FVSproject/neuroguard/Files/components.jpeg

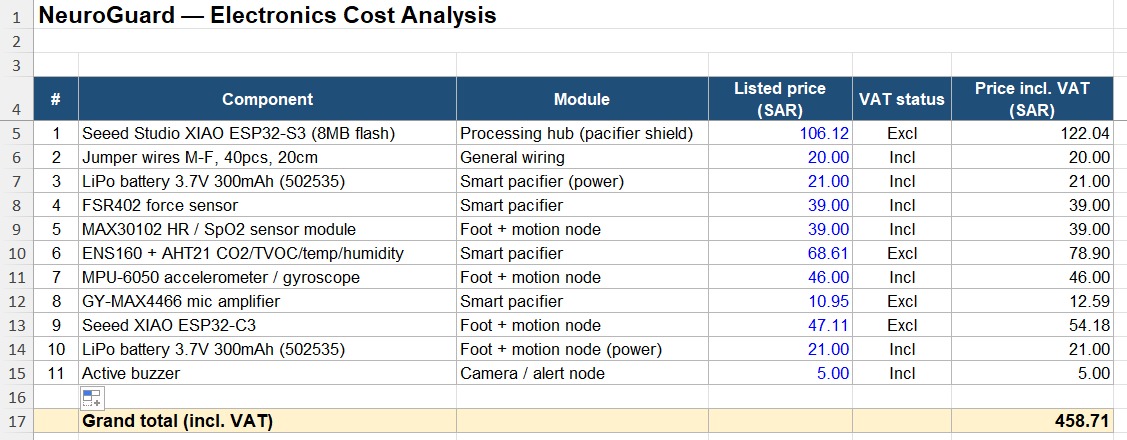
Files/components.jpeg
