FVSproject/neuroguard/Circuit/blueprint hub.png

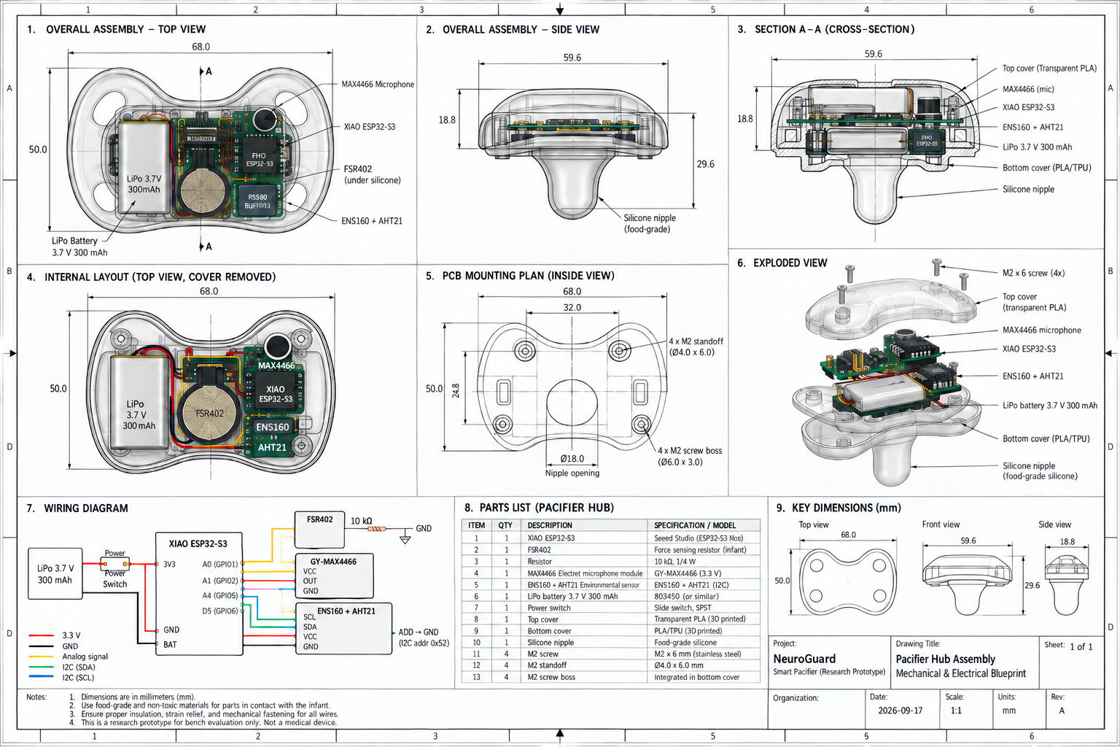
Circuit/blueprint hub.png
