FVSproject/neuroguard/Files/متلازمه_موت_الطفل_المفاجئ_Sudden_Infant_Death_Syndrome.pdf

### ما الذي يحدث فعليًا في متالزمه موت الطفل المفاجئ (SIDS (Syndrome Death Infant Sudden؟

### Brainstem Dysfunction Hypothesis

أي أن المشكلة األساسية ليست في الرئة أو القلب وحدهما، بل في جذع الدماغ.(Brainstem(

جذع الدماغ مسؤول عن:

- التنفس
- االستيقاظ من النوم
- تنظيم نبض القلب
- االستجابة لنقص األكسجين
- االستجابة الرتفاع ₂CO

وقد وجدت دراسات تشريحية متكررة وجود اضطرابات في نظام السيروتونين (System Serotonin (داخل جذع الدماغ لدى عدد كبير من أطفال SIDS.

### The Brainstem and Serotonin in the Sudden Infant Death Syndrome | Annual

Reviews (https://www.annualreviews.org/content/journals/10.1146/annurev.pathol.4.110807.092322)

ما معنى فشل االستيقاظ؟

عندما يرتفع ₂CO أثناء النوم يحدث تسلسل طبيعي:

.1 زيادة ₂CO

.2 تنشيط مستقبالت كيميائية في الدماغ .

.3 زيادة التنفس .

.4 زيادة نبض القلب .

.5 االستيقاظ .

.6 تغيير وضعية الرأس .

هذا يسمى:

### Protective Arousal Response

وقد أظهرت الدراسات أن هذه االستجابة تعتمد بشكل أساسي على دوائر عصبية داخل جذع الدماغ .

### Sudden Infant Death Syndrome, Sleep, and the Physiology and Pathophysiology of the Respiratory Network - SIDS Sudden Infant and Early Childhood Death -NCBI Bookshelf (https://www.ncbi.nlm.nih.gov/books/NBK513387/)

وجد الباحثون أن األطفال الذين توفوا الحقً SIDS أظهروا قبل الوفاة مؤشرات مثل: | ا بـ
- اضطرابات بالتنفس .

- تغيرات في HRV .
- نقص االستيقاظ .
- خلل باالستجابات الذاتية .

وكلها تشير إلى خلل في الجهاز العصبي الذاتي .

)نستنتج أن مجموعة فرعية مهمة من الرضع الذين يتوفون فجأة يعانون من اضطرابات في السيروتونين ناتجة عن "آفة مركزية" في التكوين الشبكي للنخاع المستطيل، والذي يتألف من نوى تحتوي على خاليا عصبية سيروتونينية. قد تؤدي هذه اآلفة إلى فشل استجابات جذع الدماغ الوقائية للتحديات التي تواجه التوازن الداخلي أثناء النوم في فترة نمو حرجة، مما يسبب الموت المفاجئ المرتبط بالنوم.(

### The Serotonin Brainstem Hypothesis for the Sudden Infant Death Syndrome -PMC (https://pmc.ncbi.nlm.nih.gov/articles/PMC6934437/)

المشروع:

### NeuroGuard

"تطوير نظام لهاية ذكية متعددة الحساسات لمراقبة ديناميكيات المص غير المغذي، وتقلب معدل ضربات القلب، والمؤشرات الحيوية التنفسية المرتبطة بخلل اليقظة عند الرضع"

### "Development of a Multi-Sensor Smart Pacifier System for Monitoring Non-Nutritive Sucking Dynamics, Heart Rate Variability, and Respiratory Biomarkers Associated with Arousal Dysfunction in Infants"

### الملخص(Abstract(

تُعد متالزمة موت الرضع المفاجئ (SIDS ,Syndrome Death Infant Sudden (من أهم أسباب الوفاة غير المفسرة خالل السنة األولى من العمر. وعلى الرغم من عقود من البحث العلمي، ال تزال اآلليات الفيزيولوجية الدقيقة المسؤولة عن حدوثها غير مفهومة بالكامل. تشير األدلة الحديثة إلى أن الخلل في جذع الدماغ واضطراب التنظيم العصبي الذاتي وفشل آليات االستيقاظ الوقائية (Failure Arousal (تمثل عوامل رئيسية في تطور المتالزمة. يهدف هذا المشروع إلى تطوير نظام ذكي متعدد المستشعرات يعتمد على مصاصة ذكية وحساسات فسيولوجية قابلة لالرتداء وخوارزميات ذكاء اصطناعي لتحليل المؤشرات العصبية والتنفسية بصورة متزامنة. يعتمد النظام على قياس معدل التنفس، وثاني أكسيد الكربون في الزفير، ومعدل ضربات القلب، وتباين ضربات القلب(HRV (، وتشبع األكسجين، باإلضافة إلى خصائص المص غير الغذائي (NNS ,Sucking Nutritive-Non (وتفترض الدراسة أن دمج هذه المؤشرات قد يتيح اكتشاف عالمات مبكرة على اضطراب التنظيم العصبي الذاتي المرتبط بفشل االستيقاظ قبل ظهور األحداث السريرية الخطرة .

المقدمة

تمثل متالزمة موت الرضع المفاجئ حالة وفاة مفاجئة وغير متوقعة لطفل أقل من سنة واحدة تبقى غير مفسرة حتى بعد التشريح الكامل وتحليل ظروف الوفاة والتاريخ الطبي. وتشير النماذج الحديثة إلى أن SIDS تنشأ نتيجة تفاعل بين قابلية بيولوجية كامنة، ومرحلة حرجة من تطور الجهاز العصبي، وعامل بيئي ضاغط أثناء النوم، فيما يعرف بـ .Model Risk Triple وقد أدت هذه الفرضية إلى توجيه االهتمام نحو دراسة الجهاز العصبي الذاتي ووظائف جذع الدماغ باعتبارهما مركزين رئيسيين لتنظيم التنفس واالستيقاظ .

الخلفية العلمية

- اضطرابات جذع الدماغ في SIDS

أظهرت الدراسات العصبية أن العديد من ضحايا SIDS يمتلكون اضطرابات في مناطق من جذع الدماغ مسؤولة عن التحكم بالتنفس، واالستجابة لنقص األكسجين، وتنظيم نبض القلب، واالستيقاظ من النوم. كما أشارت األبحاث إلى وجود خلل في أنظمة السيروتونين ضمن النخاع المستطيل، وهي مناطق تشارك في التحكم القلبي التنفسي واالستجابات الوقائية أثناء النوم. ويُعتقد أن هذا الخلل قد يضعف قدرة الرضيع على اكتشاف االختناق أو فرط ثاني أكسيد الكربون واالستجابة لهما بصورة مناسبة .

### Autonomic Cardiorespiratory Physiology and Arousal of the Fetus and Infant -

SIDS Sudden Infant and Early Childhood Death - NCBI Bookshelf (https://www.ncbi.nlm.nih.gov/books/NBK513398/)

### - فرضية فشل االستيقاظ (Failure Arousal(

تشير الدراسات إلى أن ارتفاع تركيز ثاني أكسيد الكربون أو انخفاض األكسجين يؤدي في الحالة الطبيعية إلى سلسلة استجابات تبدأ بزيادة الجهد التنفسي ثم تغيرات في معدل القلب والحركة واالستيقاظ من النوم وإعادة تموضع الرأس. وقد أظهرت أبحاث النوم أن هذه االستجابات تنط لق أسا ًسا من دوائر موجودة في جذع الدماغ. وتفترض فرضية فشل االستيقاظ أن بعض الرضع المعرضين لـ SIDS ال ينجحون في تفعيل هذه اآلليات الدفاعية، مما يؤدي إلى استمرار نقص األكسجين حتى الوصول إلى مرحلة حرجة .

### Sudden Infant Death Syndrome, Sleep, and the Physiology and Pathophysiology of the Respiratory Network - SIDS Sudden Infant and Early Childhood Death -NCBI Bookshelf (https://www.ncbi.nlm.nih.gov/books/NBK513387/)

### Animal Models: Illuminating the Pathogenesis of Sudden Infant Death Syndrome

- SIDS Sudden Infant and Early Childhood Death - NCBI Bookshelf (https://www.ncbi.nlm.nih.gov/books/NBK513377/)
- تباين ضربات القلب(HRV(

يعد HRV أحد أكثر المؤشرات استخدا ًما لتقييم نشاط الجهاز العصبي الذاتي. فهو يعكس التوازن بين الجهاز العصبي الودي والجهاز العصبي نظير الودي ويُستخدم لتقييم نضج التنظيم القلبي التنفسي لدى الرضع. أظهرت
دراسات على أطفال تعرضوا الحقً SIDS أو ألحداث تهدد الحياة وجود اختالفات في بعض مؤشرات HRV | ا لـ
مقارنة باألطفال الطبيعيين، مما يشير إلى أن HRV قد يمثل مؤش ًرا غير مباشر على سالمة التنظيم العصبي الذاتي .
Heart rate variability in infants with apparent life-threatening events - PubMed (https://pubmed.ncbi.nlm.nih.gov/11106044/)

### Heart rate variability in infants subsequently suffering sudden infant death

syndrome (SIDS) - ScienceDirect (https://www.sciencedirect.com/science/article/abs/pii/0378378290900803)

- المص غير الغذائي كمؤشر عصبي

المص غير الغذائي (NNS (هو أحد أقدم السلوكيات العصبية الحركية لدى الرضيع ويظهر خالل الحياة الجنينية. ويخضع للتحكم بواسطة شبكة عصبية تعرف باسم Generator Pattern Central Suck ا بين عضالت الفك واللسان والتنفس واألعصاب

ا دقيقً

الموجودة في جذع الدماغ. وتتطلب عملية المص تنسيقً القحفية، ولذلك تعتبر ديناميكية المص مؤش ًرا حسا ًسا على سالمة الجهاز العصبي المركزي. وقد أظهرت الدراسات الحديثة أن خصائص المص مثل قوة المص، وعدد الدورات، وطول النوبات، وانتظامها ترتبط بالتطور العصبي للطفل .

Non-Nutritive Sucking in the Preterm Infant - PMC (https://pmc.ncbi.nlm.nih.gov/articles/PMC6561102/)

### The association between infant non-nutritive suck and oral motor development -PMC (https://pmc.ncbi.nlm.nih.gov/articles/PMC12798892/)

- الذكاء االصطناعي وتحليل ديناميكية المص

بدأت األبحاث الحديثة في استخدام الذكاء االصطناعي لتحليل أنماط المص باعتبارها مؤشرات حيوية للتطور العصبي. وقد تمكنت نماذج التعلم العميق من اكتشاف وتصنيف أنماط المص بدقة عالية باستخدام الفيديو أو الحساسات الضاغطة، مما يؤكد أن ديناميكية المص تحتوي على معلومات عصبية يمكن استخراجها آليًا وتحويلها إلى مؤشرات كمية قابلة للتحليل .

### [2303.16867] A Video-based End-to-end Pipeline for Non-nutritive Sucking Action Recognition and Segmentation in Young Infants (https://arxiv.org/abs/2303.16867)

### [2310.16138] Subtle Signals: Video-based Detection of Infant Non-nutritive Sucking as a Neurodevelopmental Cue (https://arxiv.org/abs/2310.16138)

الفجوة البحثية

على الرغم من وجود أجهزة تقيس التنفس أو األكسجين أو نبض القلب، ال توجد أنظمة منشورة تجمع بصورة متزامنة بين:

- ديناميكية المص غير الغذائي .
- تباين ضربات القلب .
- ثاني أكسيد الكربون في الزفير .
- معدل التنفس .
- الحركة أثناء النوم .

ضمن نموذج ذكاء اصطناعي واحد يهدف إلى دراسة فشل االستيقاظ المرتبط بـ SIDS . وتشكل هذه الفجوة األساس العلمي للمشروع .
Heart rate variability in infants with apparent life-threatening events - PubMed (https://pubmed.ncbi.nlm.nih.gov/11106044/)

### Longitudinal changes in infant non-nutritive sucking across the first year of life -PMC (https://pmc.ncbi.nlm.nih.gov/articles/PMC12802502/)

الفرضية البحثية

تفترض الدراسة أن التغيرات في خصائص المص غير الغذائي بالتزامن مع التغيرات في HRV والتنفس وتركيز ₂CO يمكن أن تمثل مؤشرات حيوية رقمية مبكرة (Biomarkers Digital (الضطراب التنظيم العصبي الذاتي وفشل االستيقاظ المرتبط بمتالزمة موت الرضع المفاجئ .

### The association between infant non-nutritive suck and oral motor development -PMC (https://pmc.ncbi.nlm.nih.gov/articles/PMC12798892/)

### Longitudinal changes in infant non-nutritive sucking across the first year of life -PMC (https://pmc.ncbi.nlm.nih.gov/articles/PMC12802502/)

### التصميم الهندسي المقترح (Version Prototype(

يتكون النظام من ثالث وحدات رئيسية:

الوحدة األولى: المصاصة الذكية(Pacifier Smart(

هذه الوحدة مسؤولة عن مراقبة السلوك العصبي والتنفسي للطفل أثناء استخدام المصاصة.
: Force Sensitive Resistor (FSR) | األول | الحساس

مثل:

### FSR402 •

### FSR406 •

وظيفته:

قياس ضغط المص الواقع على المصاصة.

ومن خالله يمكن استخراج:

### - قوة المص (Strength Sucking(

- عدد المصات بالدقيقة
- مدة كل نوبة مص
- انتظام المص

### الحساس الثانيSensor Microphone :

مثل:
KY-037 •

### MAX4466 •

وظيفته:

التقاط صوت الهواء الناتج عن الشهيق والزفير.

ومن خالل معالجة اإلشارة يمكن استخراج:

- معدل التنفس
- مدة الشهيق
- مدة الزفير
- انقطاع التنفس المؤقت

الحساس الثالث -135MQ :

وظيفته:

قياس تغير تركيز الغازات ومن ضمنها ثاني أكسيد الكربون بصورة تقريبية.

الوحدة الثانية: سوار القدم

بدل اإلصبع.

### حساس30102MAX

وظيفته:

### Heart Rate •

### SpO₂ •

ومن إشارة PPG يمكن حساب:

### RR Intervals •

### HRV •

الوحدة الثالثة: وحدة الحركة

### MPU6050

يقيس:

- التسارع
- الحركة
- تغير الوضعية

ومن خالله يمكن معرفة:

- هل الطفل يتحرك؟
- هل استيقظ؟
- هل غيّر وضعيته؟

وحدة المعالجة

### ESP32

األفضل استخدام:

### ESP32 DevKit V1

ألنه يحتوي على:

### WiFi •

### Bluetooth •

- سرعة معالجة جيدة

### - ذاكرة أكبر منUno Arduino

أهم مساهمة علمية متوقعة

ال تتمثل المساهمة األساسية في تطوير مصاصة ذكية جديدة، بل في اقتراح إطار علمي جديد يدرس ما إذا كانت ديناميكية المص غير الغذائي تمثل مؤش ًرا رقميًا لوظائف جذع الدماغ والتنظيم العصبي الذاتي عند الرضع، وما إذا كان دمجها مع HRV والمؤشرات التنفسية قاد ًرا على الكشف المبكر عن اضطرابات االستيقاظ المرتبطة بمتالزمة موت الرضع المفاجئ. وهذا هو العنصر األكثر أصالة وحداثة في المشروع وفق األدبيات العلمية الحالية .
