FVSproject/neuroguard/Circuit/blueprint foot.png

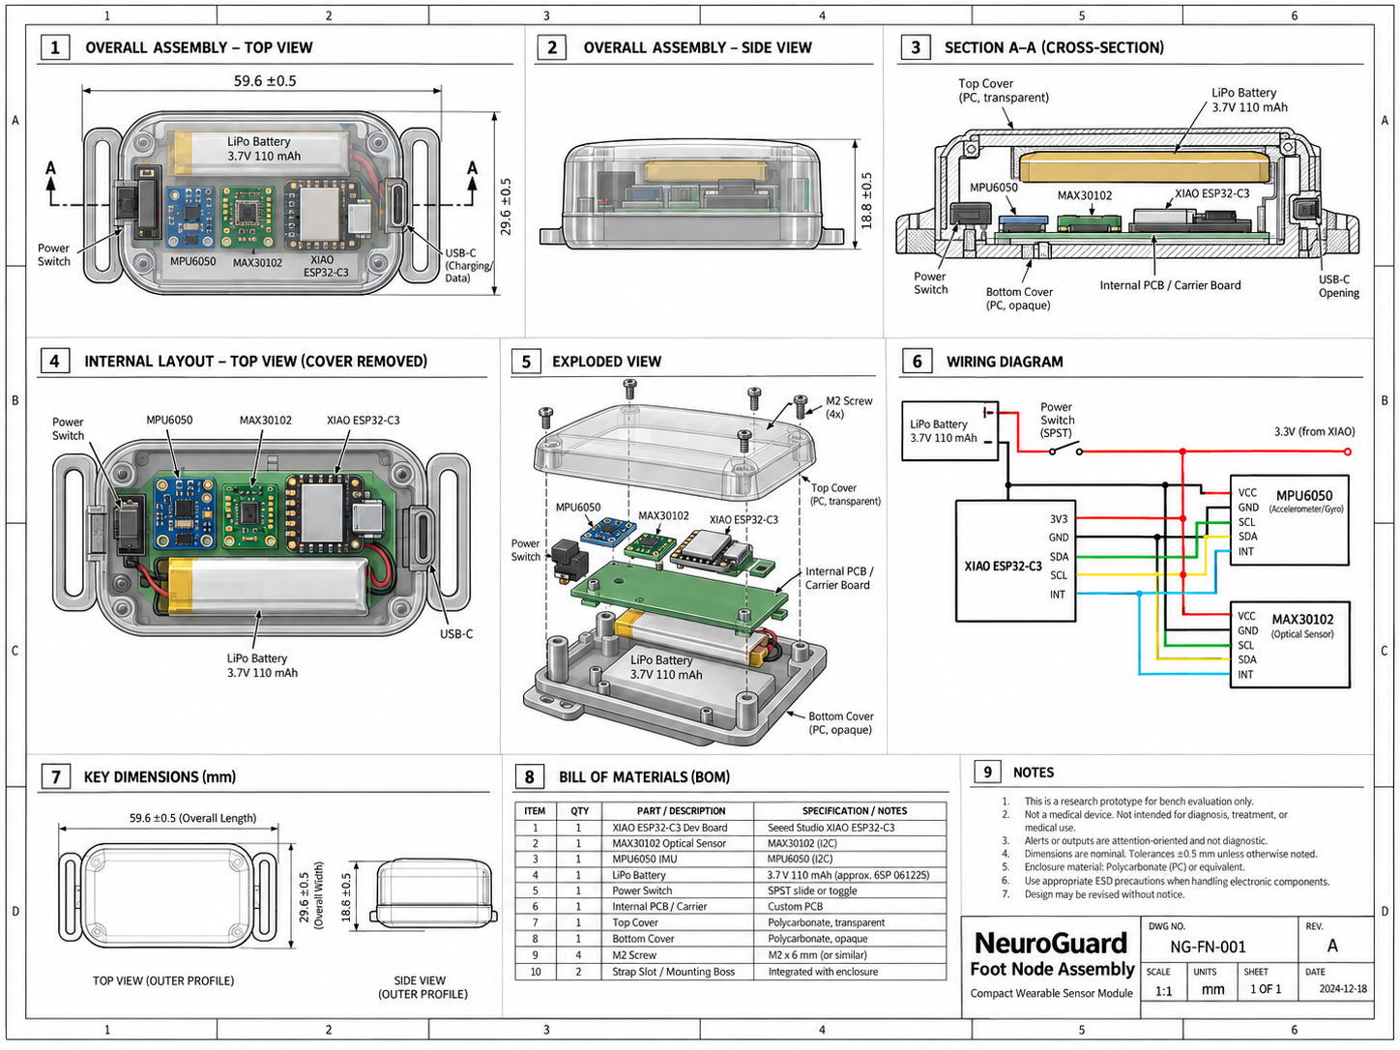
Circuit/blueprint foot.png
