FVSproject/neuroguard/Circuit/circuit_diagram2_bb.png

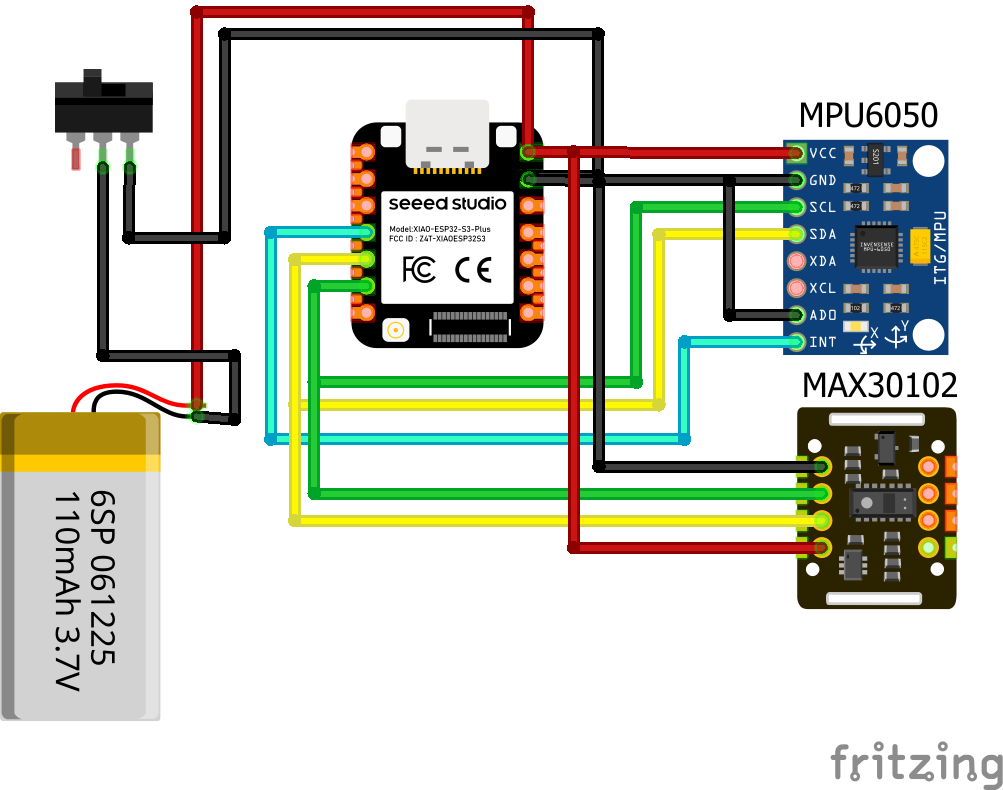
Circuit/circuit_diagram2_bb.png
