FVSproject/neuroguard/Circuit/circuit_diagram_bb.png

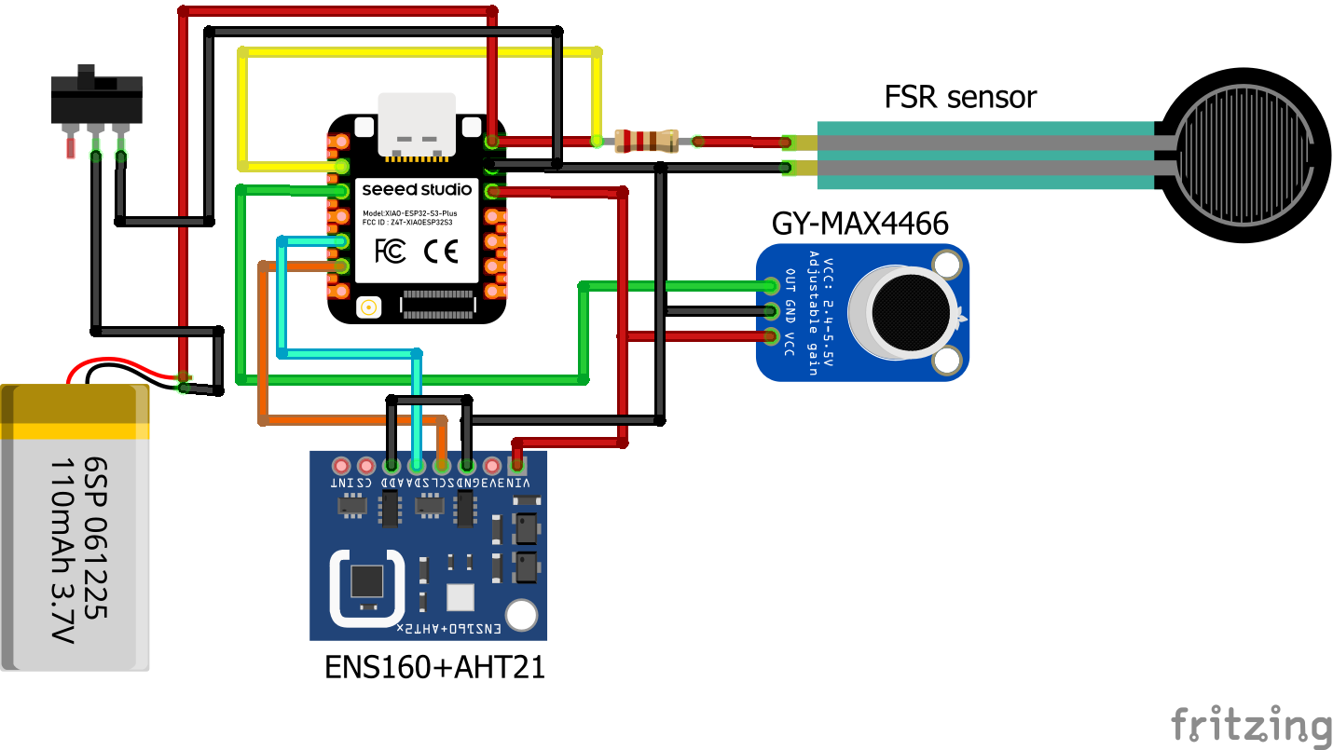
Circuit/circuit_diagram_bb.png
