FVSproject/neuroguard/Cost/NeuroGuard_Electronics_Cost_Analysis.xlsx

NeuroGuard — Electronics Cost Analysis
Fab Lab Al-Ahsa | Prices as sourced by Yusuf Ali Atwa, July 2026
# | Component | Module | Listed price (SAR) | VAT status | Price incl. VAT (SAR)
1 | Seeed Studio XIAO ESP32-S3 (8MB flash) | Processing hub (pacifier shield) | 68.02 | Excl | 230.00
3 | Jumper wires M-F, 40pcs, 20cm | General wiring | 20.00 | Incl | 20.00
4 | LiPo battery 3.7V 300mAh (502535) | Smart pacifier (power) | 21.00 | Incl | 21.00
5 | FSR402 force sensor | Smart pacifier | 39.00 | Incl | 39.00
6 | MAX30102 HR / SpO2 sensor module | Foot + motion node | 39.00 | Incl | 39.00
7 | ENS160 + AHT21 CO2/TVOC/temp/humidity | Smart pacifier | 68.61 | Excl | 78.90
9 | GY-MAX4466 mic amplifier | Smart pacifier | 10.95 | Excl | 12.59
11 | LiPo battery 3.7V 300mAh (502535) | Foot + motion node (power) | 21.00 | Incl | 21.00
12 | Active buzzer | Camera / alert node | 5.00 | Incl | 5.00
 | Grand total (incl. VAT) |  |  |  | 466.49
 | Subtotal by module (incl. VAT)
 | Module |  |  |  | Subtotal (SAR)
 | Processing hub (pacifier shield) |  |  |  | 230.00
 | Smart pacifier |  |  |  | 130.49
 | Smart pacifier (power) |  |  |  | 21.00
 | Foot + motion node |  |  |  | 39.00
 | Foot + motion node (power) |  |  |  | 21.00
 | Camera / alert node |  |  |  | 5.00
 | General wiring |  |  |  | 20.00
 | Check (should match grand total) |  |  |  | 466.49
Notes:
- Scope: electronics components only. 3D-printed/laser-cut enclosures, straps, and mounting hardware are Fab Lab stock and excluded from this sheet.
- VAT (15%, Saudi Arabia) applied to items listed as 'Excl'. Items marked 'Incl' already include VAT as quoted by the supplier.
- GY-MAX4466 mic amp VAT status was not confirmed at checkout; treated as Excl (conservative) pending confirmation.
- Camera/alert node (XIAO ESP32-S3 Sense) is USB-powered — no separate battery required.
- XIAO ESP32-S3 and XIAO ESP32-C3 boards have onboard LiPo charging circuits — no separate TP4056 modules required.
