FVSproject/neuroguard/Cost/Cost.xlsx

Cost Analysis
Proejct: |  | NeuroGuard | Total Cost work: |  |  | Cost I ask for | 600 |  | Profit
Components |  |  |  | Hardwork |  |  |  | Softwork |  |  | Meetings / Consulting
no#. | Components | Price |  | no#. | work | Price |  | no#. | work | Price | no#. | Date | Price
1 | NeuroGuard_Electronics_Cost_Analysis.xlsx | 466.49 |  | 1 |  |  |  | 1 |  |  | 1 | SD1 1/2 | 750
2 |  |  |  | 2 |  |  |  | 2 |  |  | 2 | SD1 1/2 | 750
3 |  |  |  | 3 |  |  |  | 3 |  |  | 3
4 |  |  |  |  |  |  |  | 5 |  |  | 4
5 |  |  |  |  |  |  |  | 6 |  |  | 5
6 |  |  |  |  |  |  |  |  |  |  | 6
7 |  |  |  |  |  |  |  |  |  |  | 7
8
9
10
11
12
13 |  |  |  | Total Cost |  | 0 |  | Total Cost |  | 0 | Total Cost |  | 1500
14
15
16
17
18
19
20
21
22
23
Total Cost |  | 466.49
