FVSproject/neuroguard/Cost/WhatsApp Image 2026-08-25 at 9.54.26 AM.jpeg

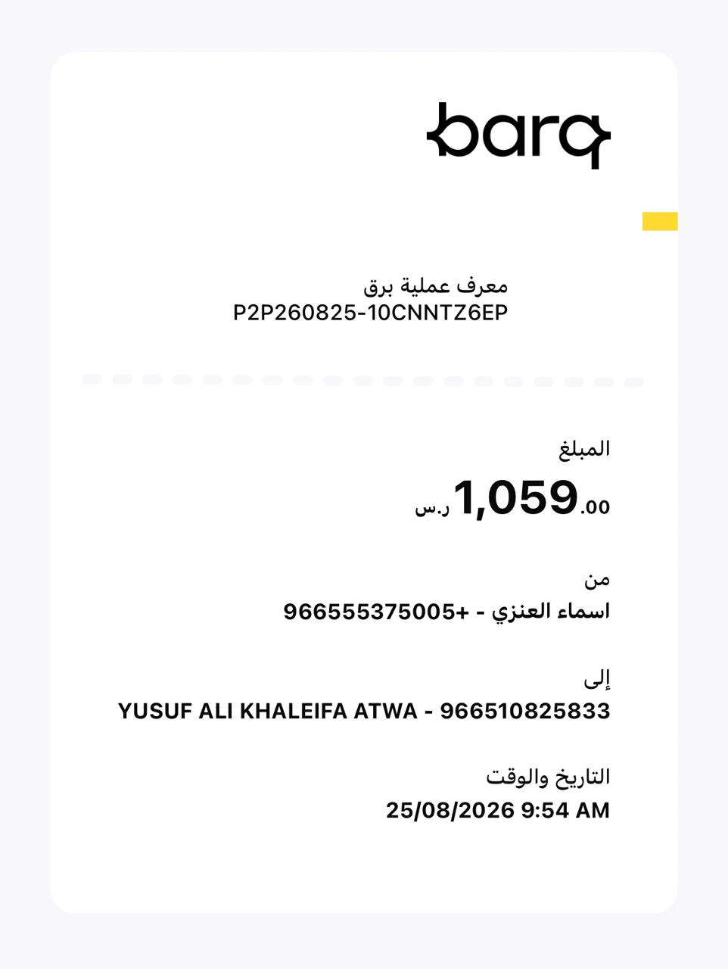
Cost/WhatsApp Image 2026-08-25 at 9.54.26 AM.jpeg
