FVSproject/neuroguard/3D design/NeuroGuard.3mf

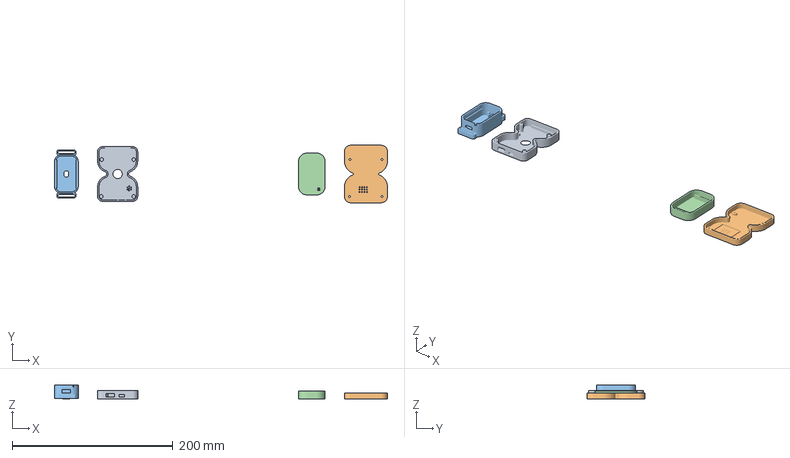
[picture p7: CAD file, 2026-09-19]
3D design/NeuroGuard.3mf
414.4 x 71.6 x 17.2 mm
NeuroGuard_Shield_v3_Base (1).stl
NeuroGuard_Shield_v3_Cap.stl
NeuroGuard_FootNode_v2_Base.stl
NeuroGuard_FootNode_v2_Cap.stl
