FVSproject/neuroguard/(list of files, drawings)

Other design files:
Circuit/circuit_diagram2.fzz
Circuit/circuit_diagram.fzz
