FVSproject/neuroguard/(commit log)

2026-09-18 Initial import: two-node NeuroGuard prototype + web app
    Firmware (code/):
    - NeuroGuard_Unit2 — foot bracelet on XIAO nRF52840 Sense
    (MAX30102 PPG, MPU-6050 IMU, custom beat detector, HRV,
    SpO2, motion + posture + stillness watchdog, BLE peripheral
    via Bluefruit)
    - RFP602_Test — pacifier hub on XIAO ESP32-S3, WiFi SoftAP
    variant with embedded web dashboard (kept as fallback)
    - NeuroGuard_Hub_BLE — same hub, Web-Bluetooth variant.
    Drops WiFi + web server, adds a BLE peripheral role that
    notifies a 77-byte packed CombinedWire snapshot every
    second; still runs BLE central to consume the bracelet.
    Web app (webapp/):
    - Next.js 16 + React 19 + Tailwind v4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
    [Cost.xlsx, NeuroGuard_Electronics_Cost_Analysis.xlsx, circuit_diagram.fzz, circuit_diagram2.fzz]
2026-09-18 i18n coverage pass + brand favicon + clear-all-data control
    Translation gaps:
    - Landing hero cards (hub + foot bullets)
    - Live page section headers, mock-stream label, apnea card title,
    HR-source chip
    - Profile field labels (Weight / Height / Gender / Notes)
    - "Everything you enter here stays on this device only" hint
    - Logs page (Events, severity filter, entries count)
    - Reports page (Summary, subtitle, avg/min/max/n/no data)
    - Settings (Vibrate on alarm label, data description)
    - Toast messages (baby created, baby deleted, photo too large)
    Favicon:
    - icon.svg — teal shield + white checkmark + peach dot,
    matches the in-app LogoMark, scales cleanly at any size.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
2026-09-18 Compact single-view dashboard + rich severity-tinted toasts
    Dashboard:
    - Sensor cards shrunk (~200 px → ~140 px tall). Sparkline is 22 px,
    value is text-3xl, threshold badge is text-[10px]. Border colour
    still tracks state so the room glow works as an ambient status.
    - Merged the two sections into one 10-card grid at
    grid-cols-2 sm:grid-cols-3 lg:grid-cols-4 xl:grid-cols-5.
    Icon colour signals the source (danger = cardiac, brand = hub,
    accent = bracelet motion) so no section headers are needed.
    Toasts:
    - New AlarmToast component (client). Per-severity look:
    watch — soft yellow gradient, warn icon
    alert — orange/red gradient, hex icon, thick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
2026-09-19 Real backend: Clerk auth + Neon Postgres via Prisma
    Rip out the local-only Dexie layer for persisted data. Live BLE + Web Audio
    alarm engine + Sonner toasts are unchanged; only the "what survives a browser
    clear" data now goes to a real server.
    Server:
    - Prisma 7 schema (prisma/schema.prisma) covers Baby, Parent,
    EmergencyContact, BabyThresholds, AlarmPrefs, LogEntry — every row
    scoped to a Clerk userId, cascading through babyId.
    - prisma.config.ts holds the Neon connection URLs (Prisma 7 removed
    `url` from schema.prisma).
    - src/lib/prisma.ts wires the @prisma/adapter-neon serverless driver
    with the ws polyfill for Node runtime.
    - src/lib/actions/{babies,thresholds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
2026-09-19 Switch stack: Supabase (auth + Postgres + RLS)
    Rip out Clerk + Prisma + Neon; move to a single-vendor Supabase setup.
    BLE + Web Audio + IndexedDB packet buffer + everything else untouched.
    - supabase/schema.sql — six tables (babies, parents, emergency_contacts,
    baby_thresholds, alarm_prefs, log_entries) plus RLS policies that scope
    every row to auth.uid(). Idempotent — safe to re-run.
    - src/lib/supabase/{client,server,middleware,types}.ts — @supabase/ssr
    wrappers plus a hand-written Database type. Row/Insert/Update/Relationships
    on every table (the last one being what postgrest-js needs to stop
    typing every query result as `never`).
    - Rewrote src/lib/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
    [NeuroGuard.3mf]
2026-09-19 Gate Google OAuth button behind NEXT_PUBLIC_ENABLE_GOOGLE_AUTH env
    Hide the Google button until Supabase's provider is actually configured, so
    users don't hit "provider is not enabled" errors. Email/password + magic
    link work out of the box regardless.
2026-09-19 Remove Google OAuth path entirely — email + magic link only
    User doesn't want Google sign-in, so drop the button, the SVG, the OAuth
    handler, the env-var gate, and the four unused message strings. AuthCard
    is 40 lines shorter and there's one less thing to configure.
2026-09-19 Settings save button + chip nowrap + live-dashboard propagation
    Fixes user report: threshold changes on the Settings page persisted but
    the running dashboard kept using the old values, and the "No data" chip
    wrapped to two lines on narrower cards.
    UI:
    - StateChip gets whitespace-nowrap + shrink-0 so it never wraps.
    - SensorCard's title container gets min-w-0 + flex-1 so the title
    truncates instead of squashing the chip. The icon is shrink-0 so it
    stays a full 14 px next to the truncated label.
    Settings flow:
    - Removed per-keystroke auto-save. All threshold + alarm-prefs edits
    buffer in local component state.
    - Added a sticky footer with a Save button. Yellow-tinted when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
2026-09-19 Per-metric warmup gate — no alarms on rolling-window rates during first minute
    User report: breath rate card doesn't make sense — alerts fire in the first
    30 s because the "60-second rolling event count" hasn't filled yet.
    Fix: honest windowing. Every metric now has a warmup period after the BLE
    session starts, and until it elapses we withhold both the alarm evaluation
    AND the numeric interpretation.
    Warmup table (src/lib/readiness.ts):
    - suckRate, breathRate, rmssd, sdnn → 60 s
    (all firmware-computed as "count in last 60 s"; before 60 s they
    under-report by design)
    - eco2, tvoc, aqi → 180 s
    (ENS160 datasheet warmup; RFP602_Test doesn't gate t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
2026-09-19 Show raw mic pk-pk % under Breathing Rate — verify sensor before trusting rate
    User doesn't trust the derived breath rate and wants proof the mic is
    actually picking up sound. Fair — the ÷2 heuristic and the fixed 300-count
    threshold are both suspect enough that a bench sanity check should live in
    the UI, not in the terminal.
    New MicLevel component (src/components/sensor/mic-level.tsx):
    - Mic icon + horizontal bar + tabular percentage.
    - 0 % = silence, 100 % = 2048 pk-pk (half-rail swing — a shout / clap).
    - Bar turns brand-teal once raw pk-pk crosses the firmware's 300-count
    breath-event threshold, muted grey below it. So the user watches the
    threshold get crossed in r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
2026-09-19 Breath-event threshold → 17 % (350 pk-pk) in both firmware + UI
    User asked for the breath count to trigger whenever mic level ≥ 17 %.
    17 % of the 12-bit ADC's 2048 half-swing = ~350 counts.
    Firmware (both RFP602_Test.ino and NeuroGuard_Hub_BLE.ino):
    - BREATH_ON_PKPK 300 → 350
    - BREATH_OFF_PKPK 150 → 175 (hysteresis kept at 50 % of ON)
    Reflash the hub for these to take effect. Bracelet firmware unchanged.
    Web app (MicLevel):
    - BREATH_ON_PCT constant = 17. Bar turns brand-teal at exactly this
    percentage, matching where the firmware fires a breath event.
    - Added a fixed tick mark on the meter at 17 % so the parent sees the
    trigger point visually and can watch the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
    [NeuroGuard_Hub_BLE.ino, RFP602_Test.ino]
2026-09-19 FSR level meter + lower suck threshold to 8 % — every gentle press counts
    User: 'each press on FSR should be considered as one suck'. That was really
    two things: (a) verify the sensor is seeing the press, (b) lower the trigger
    so lighter presses don't get filtered out.
    Firmware (both RFP602_Test + NeuroGuard_Hub_BLE):
    - SUCK_ON_PCT 15 → 8 (catches gentle presses, still comfortably above
    the FSR_DEADBAND noise floor of 20 counts)
    - SUCK_OFF_PCT 8 → 3 (~40 % of ON, hysteresis kept sane)
    Reflash the hub for these to take effect.
    Web app:
    - New FsrLevel component (mirror of MicLevel): Hand icon + horizontal
    bar + tabular %, tick at 8 % showin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
    [NeuroGuard_Hub_BLE.ino, RFP602_Test.ino]
2026-09-19 Fix React #418 hydration mismatch on BLE status
    The ble-store initial status read `navigator.bluetooth` at module load, so
    SSR resolved to "unsupported" (navigator undefined) while the client
    resolved to "disconnected" — the connection chip rendered a different
    HubIcon on each side and React tore down the hydrated tree.
    Initial status is now "disconnected" everywhere; useBle flips it to
    "unsupported" from a mount effect that only runs on the client, after
    hydration has settled.
2026-09-19 Bracelet↔hub BLE: cache MAC + directed reconnect + full-duty scan
    The 5–15 s reconnect lag was Bluedroid's scan-discovery latency
    (75 % duty, plus a first-adv-window race) combined with a blocking
    connect() that could stall the main loop for tens of seconds if the
    bracelet had moved out of range.
    Fixes on the hub (central):
    * Cache the bracelet MAC after the first successful pair. Subsequent
    reconnects use a directed connect straight to the cached address,
    skipping scan discovery entirely — typical reconnect <1 s.
    * Cap the directed connect timeout at 2 s so a stale MAC / offline
    bracelet doesn't block the FSR + mic sampling loop.
    * Raise scan duty to ~100 % (window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
    [NeuroGuard_Hub_BLE.ino, NeuroGuard_Unit2.ino]
2026-09-19 Fix build: use Arduino BLE_ADDR_PUBLIC, not esp-idf BLE_ADDR_TYPE_PUBLIC
    The Arduino ESP32 BLE wrapper exposes BLEAddress.h with BLE_ADDR_PUBLIC.
    BLE_ADDR_TYPE_PUBLIC lives in esp_gap_ble_api.h and isn't transitively
    included by BLEDevice.h, so it fails to compile in an .ino sketch.
    [NeuroGuard_Hub_BLE.ino]
2026-09-19 Adaptive breath detector — stops stalling in noisy rooms
    The fixed-threshold detector (fire at pk-pk >= 350, rearm at <= 175) locks
    into "high" state whenever ambient noise keeps pk-pk above the rearm
    threshold. With a ~22 % ambient bar height (raw ~450), the very first
    sample fires and then no crossings ever register — user sees "0 ev" for
    the whole session.
    Replace with an EMA-baseline detector:
    * Baseline follows ambient pk-pk. Fast decay when signal drops below
    baseline (silence just returned), slow rise when above (so a loud
    breath doesn't drag the baseline up before we can fire on the next).
    * Fire when pk-pk exceeds baseline + 300 counts, floored at the
    original B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
    [NeuroGuard_Hub_BLE.ino]
2026-09-19 Add "Pair bracelet" button + hub CMD channel
    Users had no way to force a bracelet re-pair from the browser; if the hub
    got stuck reconnecting to a bracelet whose MAC had rotated, the only
    recourse was a physical power cycle.
    Firmware (bundled in the previous commit's hub .ino for compactness):
    * New writable BLE characteristic NG_HUB_CMD_CHR_UUID (b2c3d4e7-…).
    * 1-byte opcode HUB_CMD_RESCAN_BRACELET = 0x01.
    * Handler drops the cached MAC, disconnects any in-flight client, and
    flips bleScanning=false so the next central tick restarts scanning.
    * `sendHubCommand(op)` in ble.ts, backed by a cached CMD characteristic
    populated on connect and cleared on disconnect. Op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
2026-09-19 Simplify breath detector: pure rising-edge crossing of 17 %
    Per feedback, drop the adaptive-baseline detector. What's wanted is
    literally "whenever pk-pk crosses 17 %, count 1" — nothing more.
    * Track previous pk-pk sample.
    * Fire when previous < BREATH_ON_PKPK AND current >= BREATH_ON_PKPK.
    * Keep the 250 ms refractory to guard against a single crossing that
    jitters across the threshold twice.
    * Removed the unused `breathActive` state.
    Ambient noise handling belongs to the mic hardware side (gain / mount /
    shielding) or to raising the 17 % threshold — not to the detector logic.
    [NeuroGuard_Hub_BLE.ino]
2026-09-19 Breath detector: 1 event per second while pk-pk >= 17 %
    Per feedback, drop rising-edge / hysteresis complexity. The counter should
    just tick up by 1 per second while the mic is above the 17 % threshold,
    and pause (not reset) when below.
    * BREATH_REFRACT_MS 250 -> 1000 (now the tick cadence, not a debounce).
    * updateBreathDetector fires whenever pkpk >= BREATH_ON_PKPK and >= 1 s
    since the last fire. No prev-sample tracking, no active-state flag.
    * Removed the unused BREATH_OFF_PKPK constant.
    BLE central + bracelet advertising left untouched (stable per bench test).
    [NeuroGuard_Hub_BLE.ino]
2026-09-19 Align breaths/min value with the raw event count (drop /2)
    The old est_breaths_per_min = nBreath/2 was a leftover of the
    inhale+exhale-count-as-2-events heuristic. With the current
    tick-per-second detector, one event = one second above threshold, so
    the divisor makes the main value disagree with the "N ev" chip
    (chip shows 5, main shows 2). Set them equal.
2026-09-23 Client-side breath detector — fire on 17 % crossing in the webapp
    Firmware-side breath detection has been unreliable through several
    iterations (fixed hysteresis stalled in noisy rooms, rising-edge missed
    first-fire, tick-per-second confused users). Rather than another flash
    cycle, do the detection in the web app itself off the mic_pkpk_now field
    that already ships in every packet.
    New hook `useClientBreathCount` subscribes to the packet stream, tracks
    the previous pk-pk %, and pushes an event to a 60 s rolling ring on
    every upward crossing of the 17 % threshold — the same tick MicLevel
    draws — so the "N ev" chip and the level bar stay visibly consistent.
    Resets on disconnect; drains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
2026-09-23 Breath count: cumulative display + rolling 60 s hint
    Rolling-window semantics were confusing users ("why does it decrement?").
    Split the counter into two:
    * `total` — cumulative since session start, monotonic, never
    decrements. Resets only on disconnect. Shown as the
    main "N breaths" value on the card and inside the
    "N ev" chip.
    * `window60s` — rolling count in the last 60 s, tracked internally
    and surfaced only as a caption under the level bar:
    "Cumulative since connect · rolling 60 s: N".
    Retitled the card "Breathing rate" -> "Breathing" and unit
    "breaths/min" -> "breaths" so the label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
2026-09-23 Smooth the mic bar with EMA — kill spike-jitter without hiding breaths
    The raw pk-pk from a single 50 ms window is genuinely spiky (real
    acoustic input is), and rendering that raw value made the bar
    appear to jump to 70 % on stray noise even when the environment was
    otherwise quiet.
    Add a shared EMA smoother in `useClientBreathCount` (alpha 0.35 — old
    value 65 %, new value 35 %) and expose the smoothed % alongside the
    counts. The Live page passes it into MicLevel as `smoothPct`, which
    drives BOTH the visible bar AND the teal/grey threshold color. The
    crossing detector uses the same smoothed value, so the "N ev" chip
    and the visible bar stay perfectly synchronised — no chip ticking
    wit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
2026-09-23 Revert EMA smoothing on mic bar — was showing 86 % in silence
    The EMA (0.65 old + 0.35 new) let a single noise spike bleed forward
    across many packets, so a brief electrical / EMI pulse would leave the
    bar sitting near the spike amplitude even after the environment went
    back to quiet. Users reported "86 % with no sound at all".
    Go back to displaying the raw pk-pk % straight from mic_pkpk_now — the
    version that was working before. Bar is jittery on real acoustic noise
    (unavoidable — a 50 ms window IS a spiky measurement), but it now
    faithfully reflects what the mic is actually seeing rather than a
    lag-window average of spikes past.
    Threshold stays at 27 %, cumulative counter + 60 s no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
2026-09-23 Bracelet link: stop false "offline" flicker, self-healing reconnect
    Hub (ESP32-S3, NimBLE):
    - Fix bracelet age underflow. loop() captured `now` before 50-140 ms of
    sensor reads; a notify landing in that gap made `now - lastRx` wrap to
    ~4e9, so a healthy bracelet was reported offline in runs as the two
    1 Hz clocks drifted. Age now uses a fresh millis() with signed math.
    - Move the bracelet central into its own FreeRTOS task. NimBLE's
    BLEClient::connect() ignores its timeout argument and blocks up to
    31 s, which froze mic/FSR sampling and the browser packet.
    - Scan-gated connect (only connect to an address heard advertising
    moments ago); 50 % scan duty to leave airtime for the brow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
    [NeuroGuard_Hub_BLE.ino, NeuroGuard_Unit2.ino]
2026-09-23 Suck trigger 8 % -> 25 %, release 3 % -> 15 %
    A suck is only recorded when the FSR falls back below the release
    threshold. With release at 3 %, an FSR that settled at 4-7 % after a
    press left the detector stuck "active" and counting stopped. Raise the
    trigger to 25 % (per request) and release at 15 %, well above the
    resting level, with a 10-point gap to prevent double counts. Web FSR
    bar tick moved to 25 % to match.
    [NeuroGuard_Hub_BLE.ino, RFP602_Test.ino]
2026-09-28 Breath line 27 % -> 40 %; make breath rate, apnea and alarms agree
    Checking the counting turned up three inconsistencies:
    - The Breathing card's state chip judged the cumulative total against
    the per-minute band (20-60), so it went Alert/Critical after a minute
    or two of normal breathing.
    - Alarms and sparklines still read the hub's own breath detector (17 %
    line), not the browser counter shown on the card.
    - The apnea timer came from the hub's 17 % detector; room noise above
    17 % kept it near 0, so the apnea alarm could never fire.
    Move breath state into an app-wide store fed by one tracker (mounted in
    AlarmMount): cumulative total, 60 s rate, and the last time the mic was
    at/above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
